Gambalunga/Talking-LCD-Clock-Adafruit-Feather-M4-Express/Images/20201104_095538.jpg

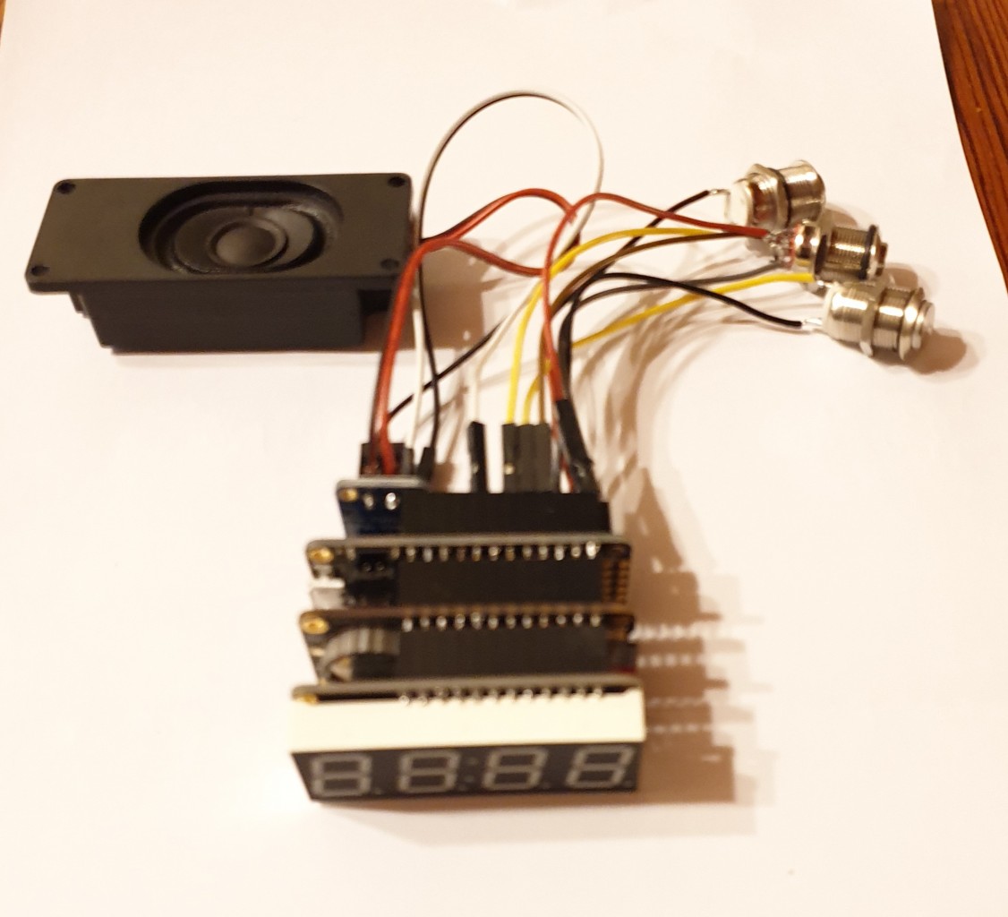
Images/20201104_095538.jpg
